ambient-robots/xlerobot_pinc/hardware/custom_parts/SO107_Elbow_Roll_Link.step

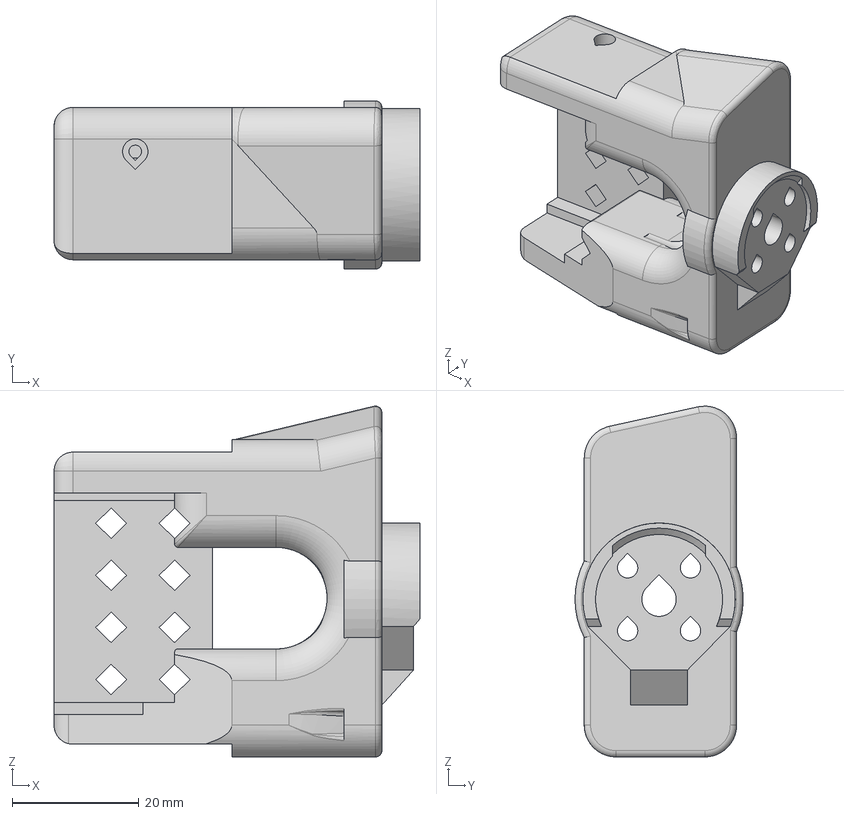
[picture p1: CAD file, 2026-03-20]
hardware/custom_parts/SO107_Elbow_Roll_Link.step
57.6 x 26.5 x 55.3 mm
