ambient-robots/xlerobot_pinc/xlerobot_pinc_urdf/assets/035armbase_step__4.stl

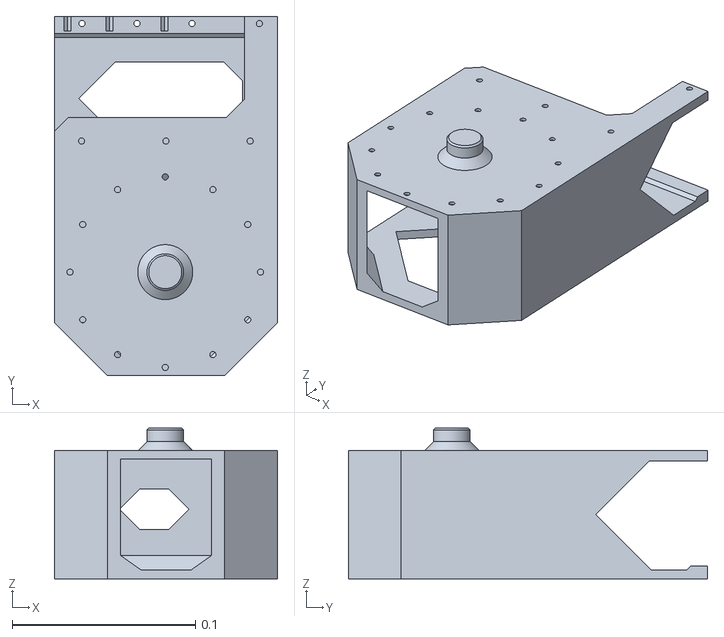
[picture p2: CAD file, 2026-03-18]
xlerobot_pinc_urdf/assets/035armbase_step__4.stl
0.122 x 0.196 x 0.0824
