ambient-robots/xlerobot_pinc/hardware/custom_parts/SO107_Elbow_Flex_Link.step

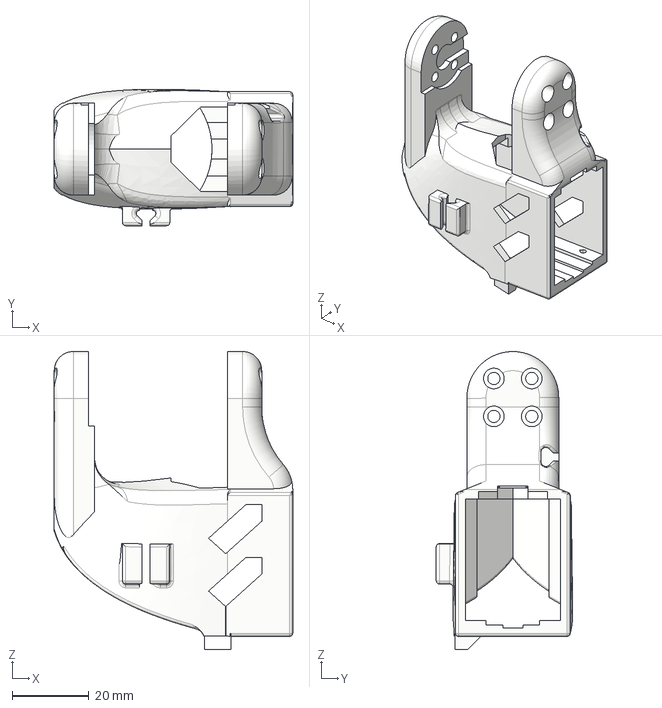
[picture p3: CAD file, 2026-03-20]
hardware/custom_parts/SO107_Elbow_Flex_Link.step
62.3 x 35.6 x 77.8 mm
