ambient-robots/xlerobot_pinc/xlerobot_pinc_urdf/assets/gimbal_base_step.stl

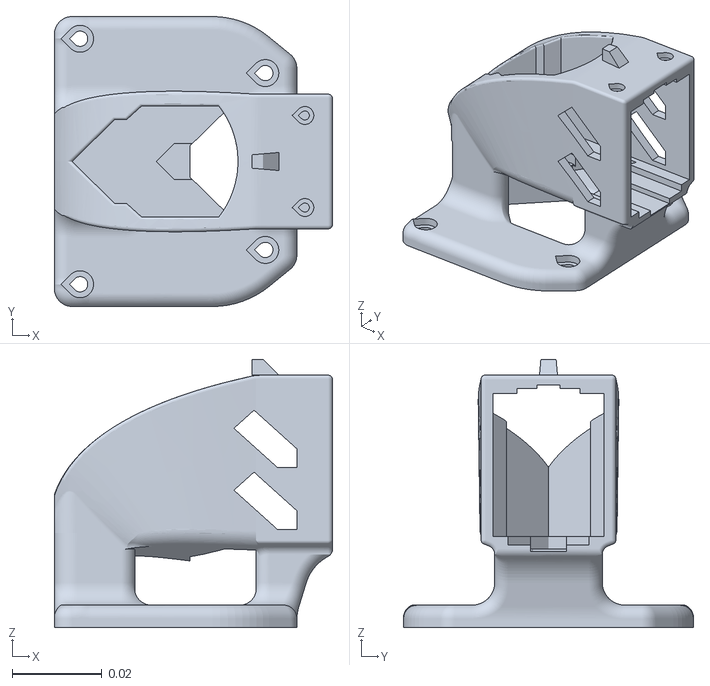
[picture p4: CAD file, 2026-03-18]
xlerobot_pinc_urdf/assets/gimbal_base_step.stl
0.062 x 0.0646 x 0.0597
