ambient-robots/xlerobot_pinc/hardware/custom_parts/PincOpen_Pointy_Tip_TPU95.step

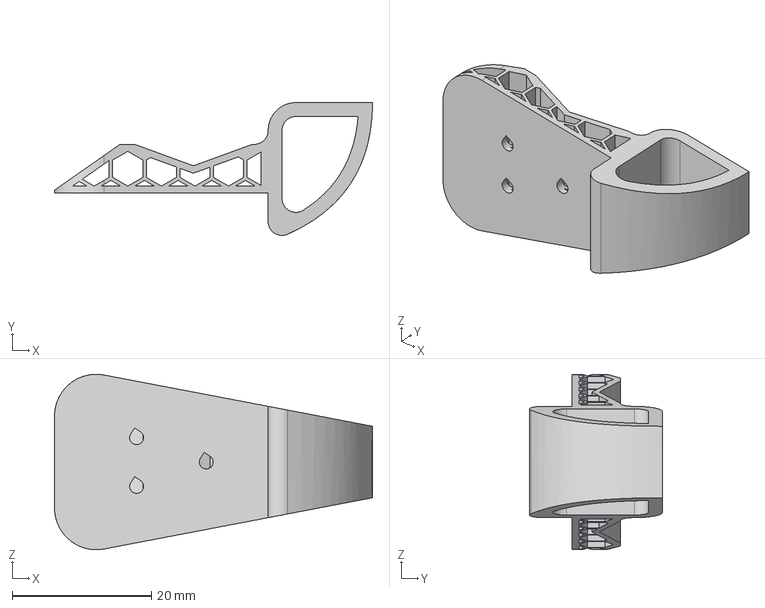
[picture p5: CAD file, 2026-03-20]
hardware/custom_parts/PincOpen_Pointy_Tip_TPU95.step
45.7 x 19.1 x 25.2 mm
