ambient-robots/xlerobot_pinc/xlerobot_pinc_urdf/assets/035armbase_step.stl

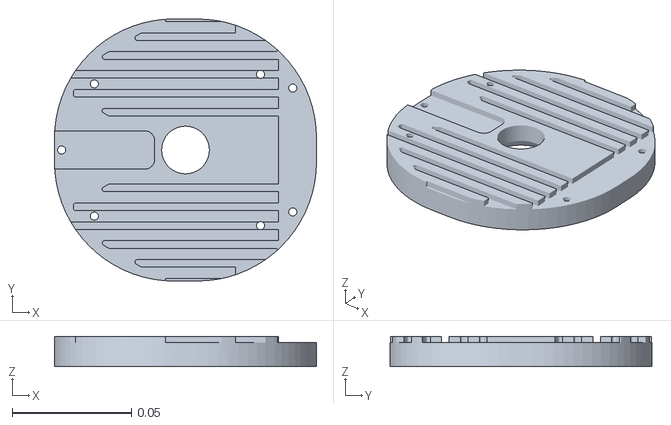
[picture p6: CAD file, 2026-03-18]
xlerobot_pinc_urdf/assets/035armbase_step.stl
0.11 x 0.11 x 0.0126
