ambient-robots/xlerobot_pinc/hardware/custom_parts/PincOpen_Fisheye_Camera_Holder_38x38.step

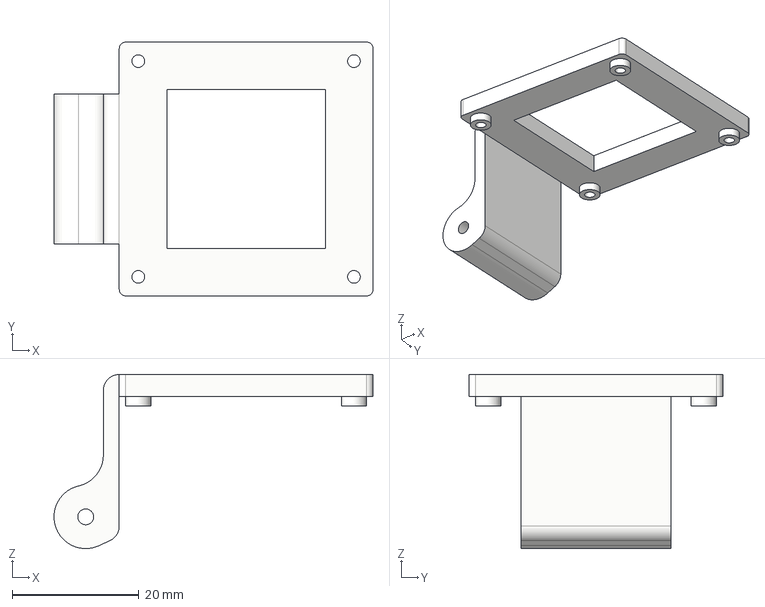
[picture p7: CAD file, 2026-03-20]
hardware/custom_parts/PincOpen_Fisheye_Camera_Holder_38x38.step
50.3 x 40.0 x 27.4 mm
