ambient-robots/xlerobot_pinc/xlerobot_pinc_urdf/assets/xlerobot_0_2_9bas_step.stl

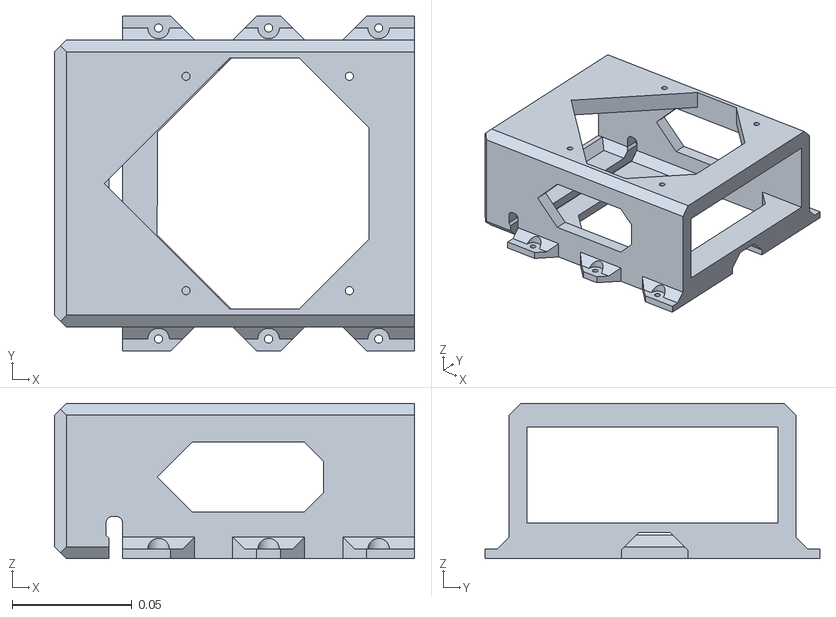
[picture p8: CAD file, 2026-03-18]
xlerobot_pinc_urdf/assets/xlerobot_0_2_9bas_step.stl
0.151 x 0.14 x 0.065
