ambient-robots/xlerobot_pinc/xlerobot_pinc_urdf/assets/xlerobot_0_2_9_3d_step.stl

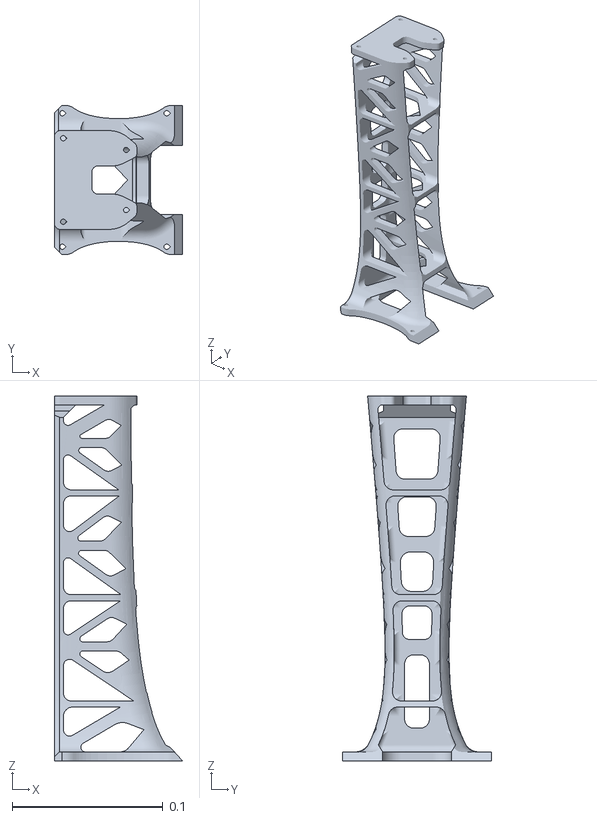
[picture p9: CAD file, 2026-03-18]
xlerobot_pinc_urdf/assets/xlerobot_0_2_9_3d_step.stl
0.0852 x 0.0992 x 0.243
