ambient-robots/xlerobot_pinc/xlerobot_pinc_urdf/assets/base_motor_holder_so101_v1.stl

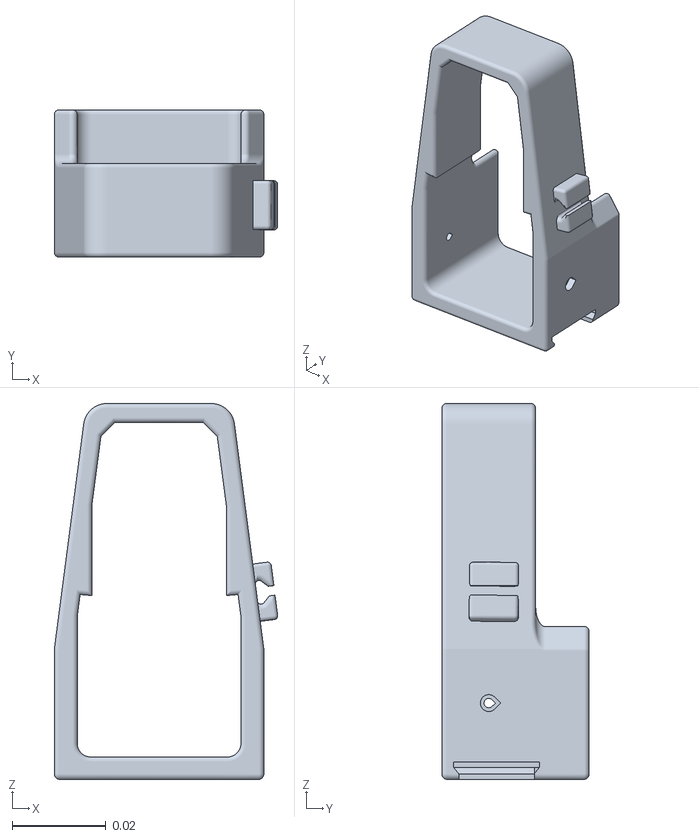
[picture p11: CAD file, 2026-03-17]
xlerobot_pinc_urdf/assets/base_motor_holder_so101_v1.stl
0.0476 x 0.0314 x 0.0802
