ambient-robots/xlerobot_pinc/xlerobot_pinc_urdf/assets/upper_arm_so101_v1.stl

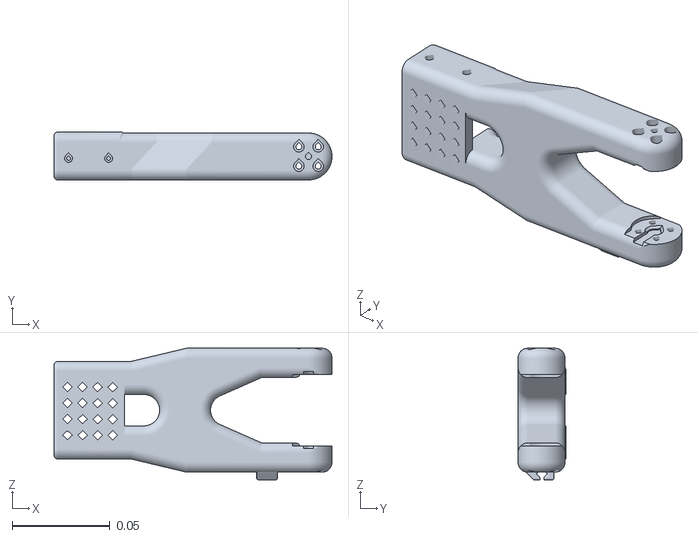
[picture p12: CAD file, 2026-03-17]
xlerobot_pinc_urdf/assets/upper_arm_so101_v1.stl
0.142 x 0.0245 x 0.0673
