ambient-robots/xlerobot_pinc/xlerobot_pinc_urdf/assets/internal_rod.stl

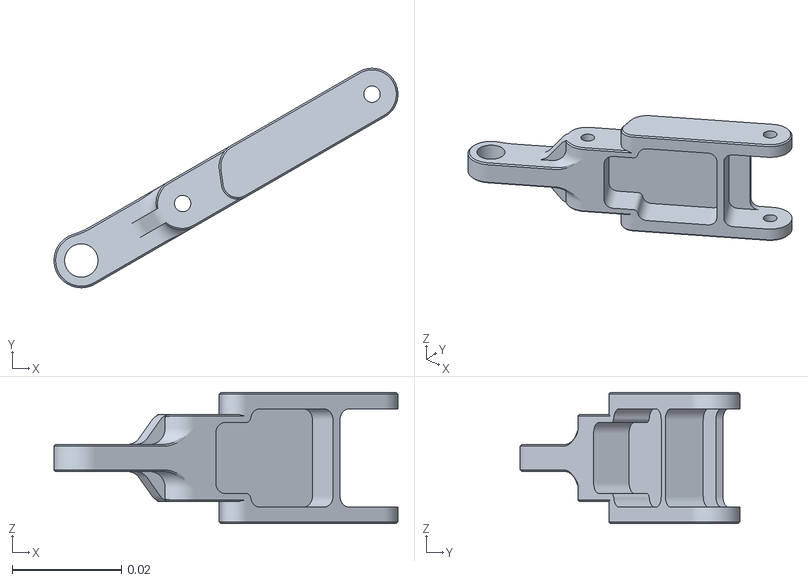
[picture p13: CAD file, 2026-03-17]
xlerobot_pinc_urdf/assets/internal_rod.stl
0.0629 x 0.0402 x 0.024
