ambient-robots/xlerobot_pinc/xlerobot_pinc_urdf/assets/sts3215_03a_v1__2.stl

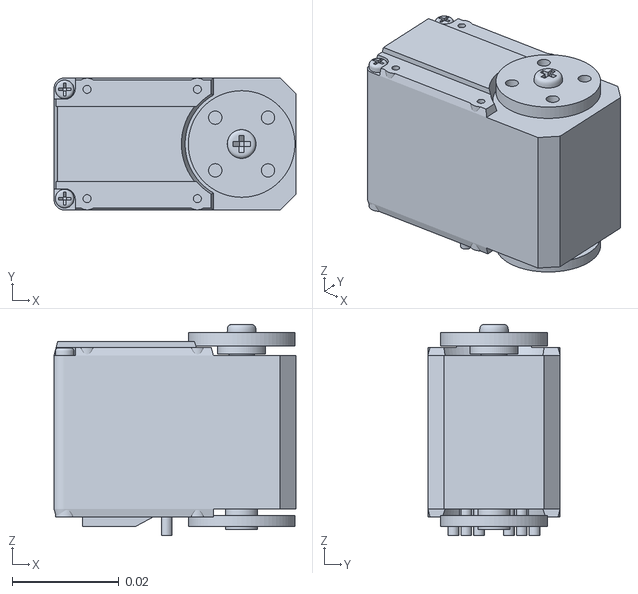
[picture p14: CAD file, 2026-03-17]
xlerobot_pinc_urdf/assets/sts3215_03a_v1__2.stl
0.0454 x 0.0248 x 0.0396
