ambient-robots/xlerobot_pinc/xlerobot_pinc_urdf/assets/top_plate.stl

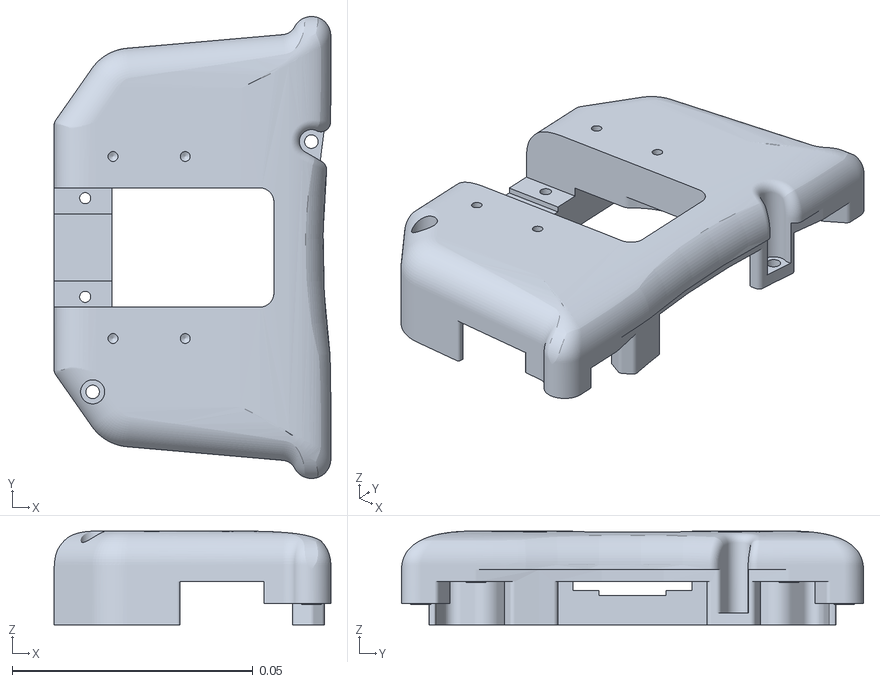
[picture p15: CAD file, 2026-03-17]
xlerobot_pinc_urdf/assets/top_plate.stl
0.0575 x 0.096 x 0.0195
