ambient-robots/xlerobot_pinc/xlerobot_pinc_urdf/assets/wrist_roll_pitch_so101_v2.stl

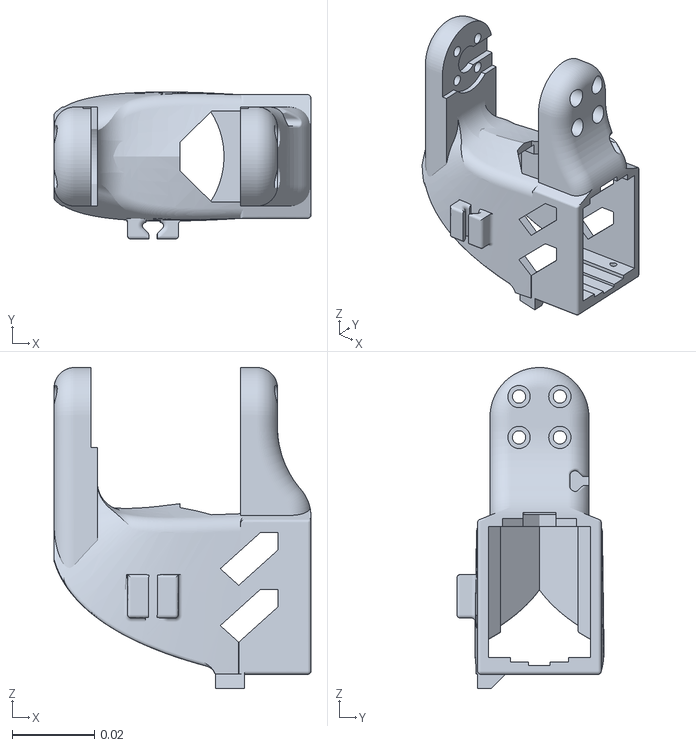
[picture p16: CAD file, 2026-03-17]
xlerobot_pinc_urdf/assets/wrist_roll_pitch_so101_v2.stl
0.0623 x 0.0357 x 0.0778
