ambient-robots/xlerobot_pinc/xlerobot_pinc_urdf/assets/rotation_pitch_so101_v1.stl

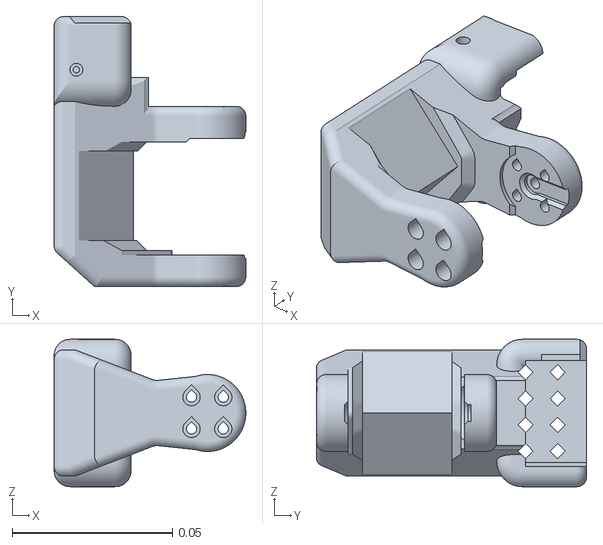
[picture p17: CAD file, 2026-03-17]
xlerobot_pinc_urdf/assets/rotation_pitch_so101_v1.stl
0.0598 x 0.0842 x 0.046
