ambient-robots/xlerobot_pinc/xlerobot_pinc_urdf/assets/removable_tip.stl

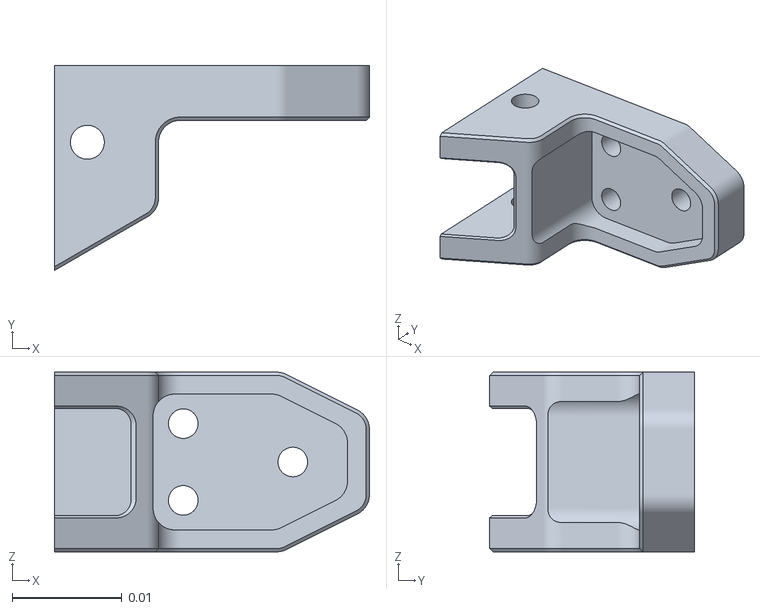
[picture p18: CAD file, 2026-03-17]
xlerobot_pinc_urdf/assets/removable_tip.stl
0.0287 x 0.0187 x 0.0164
