ambient-robots/xlerobot_pinc/xlerobot_pinc_urdf/assets/driving_rod.stl

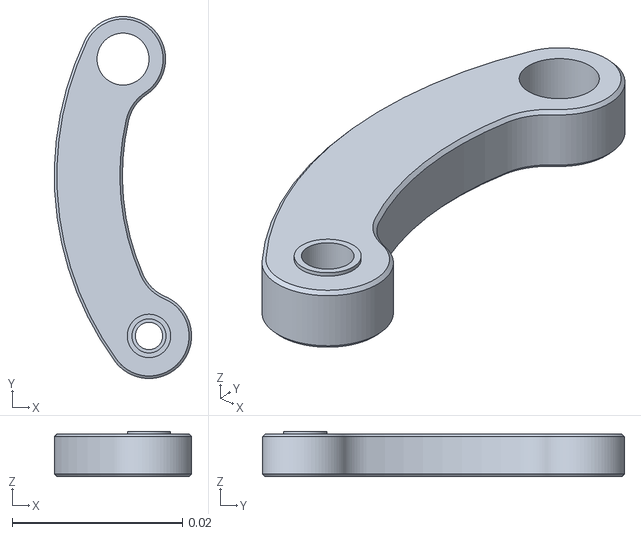
[picture p19: CAD file, 2026-03-17]
xlerobot_pinc_urdf/assets/driving_rod.stl
0.0161 x 0.0425 x 0.0053
