ambient-robots/xlerobot_pinc/xlerobot_pinc_urdf/assets/distal_rod.stl

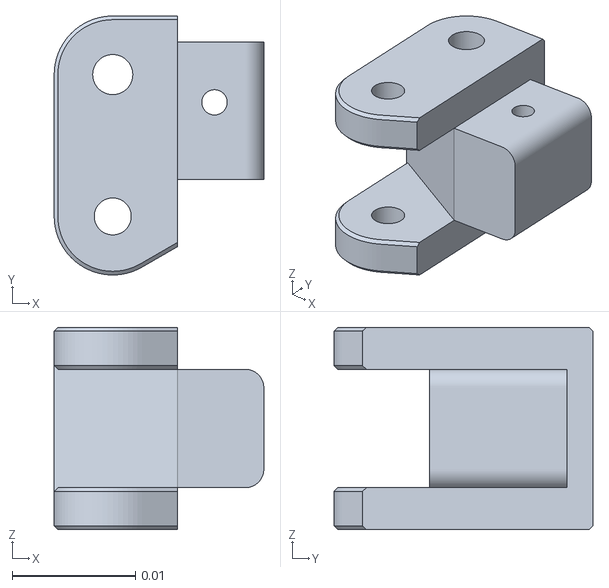
[picture p20: CAD file, 2026-03-17]
xlerobot_pinc_urdf/assets/distal_rod.stl
0.017 x 0.021 x 0.0164
