ambient-robots/xlerobot_pinc/xlerobot_pinc_urdf/assets/component1___use.stl

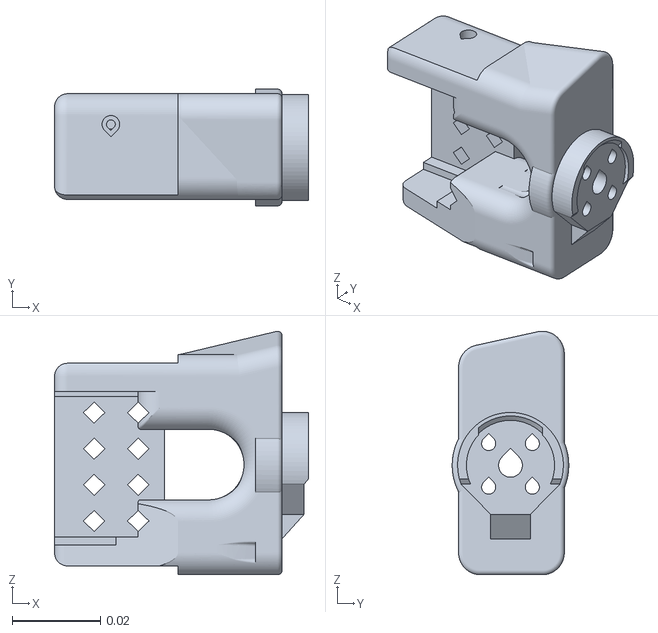
[picture p21: CAD file, 2026-03-17]
xlerobot_pinc_urdf/assets/component1___use.stl
0.0576 x 0.0265 x 0.0553
