ambient-robots/xlerobot_pinc/xlerobot_pinc_urdf/assets/distal_shell.stl

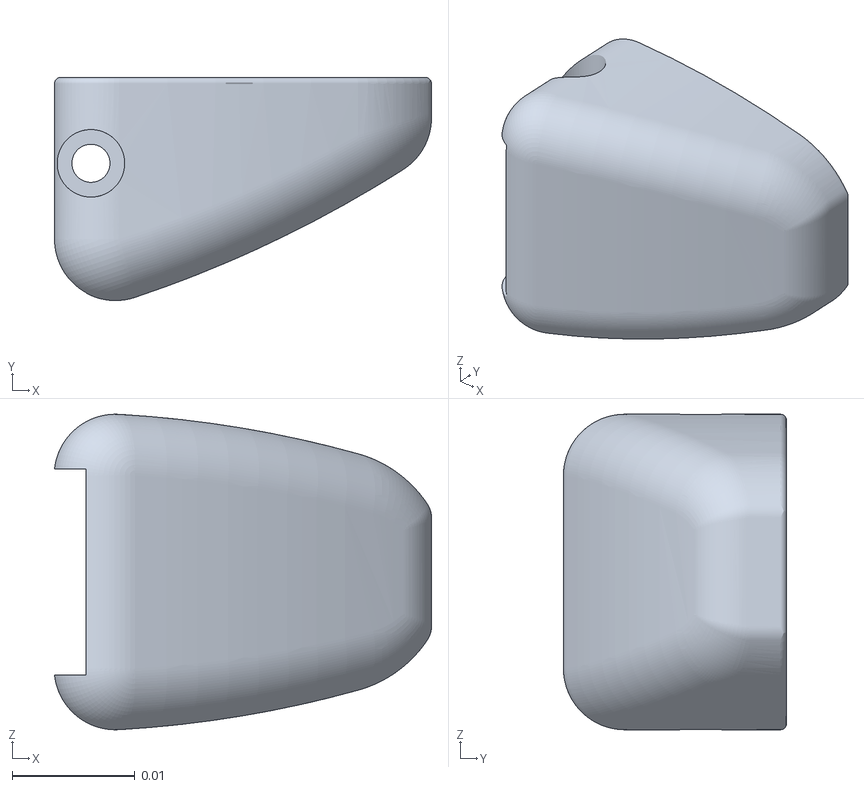
[picture p22: CAD file, 2026-03-17]
xlerobot_pinc_urdf/assets/distal_shell.stl
0.0307 x 0.0182 x 0.0257
