ambient-robots/xlerobot_pinc/xlerobot_pinc_urdf/assets/camera_mobile_sup.stl

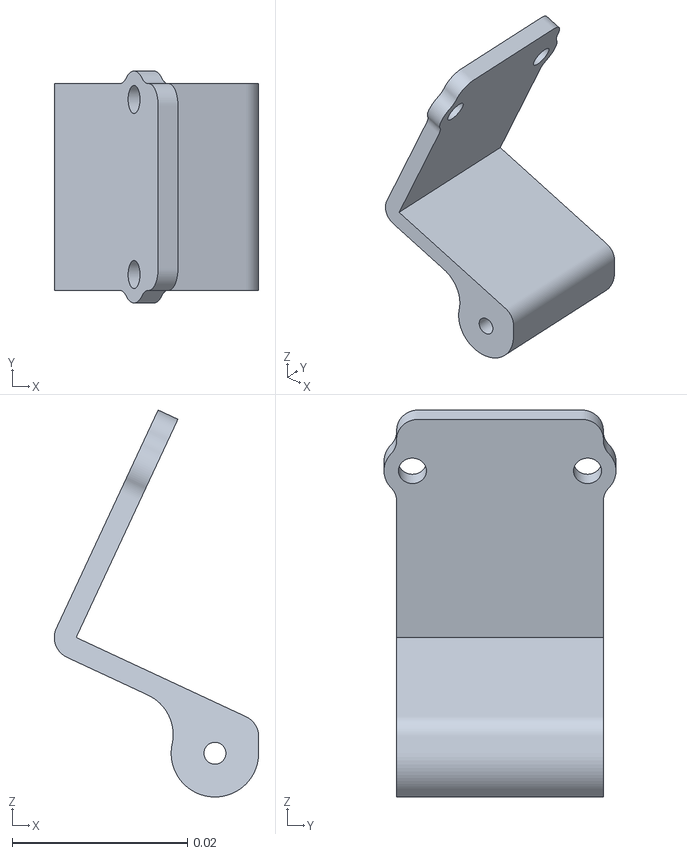
[picture p23: CAD file, 2026-03-17]
xlerobot_pinc_urdf/assets/camera_mobile_sup.stl
0.0233 x 0.0265 x 0.0442
