ambient-robots/xlerobot_pinc/xlerobot_pinc_urdf/assets/motor_holder_so101_wrist_v1.stl

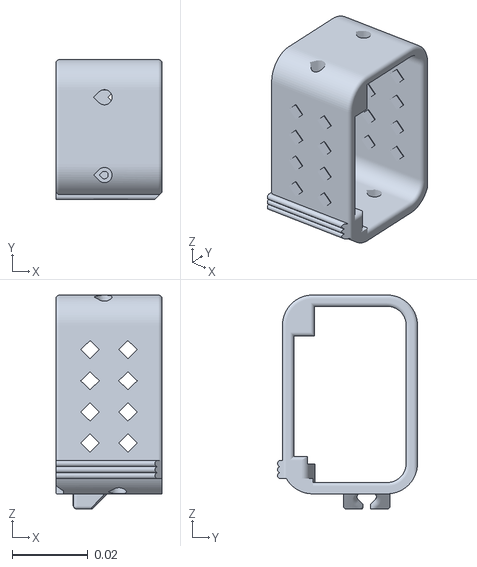
[picture p24: CAD file, 2026-03-17]
xlerobot_pinc_urdf/assets/motor_holder_so101_wrist_v1.stl
0.028 x 0.0369 x 0.0564
