ambient-robots/xlerobot_pinc/xlerobot_pinc_urdf/assets/interface_arm100.stl

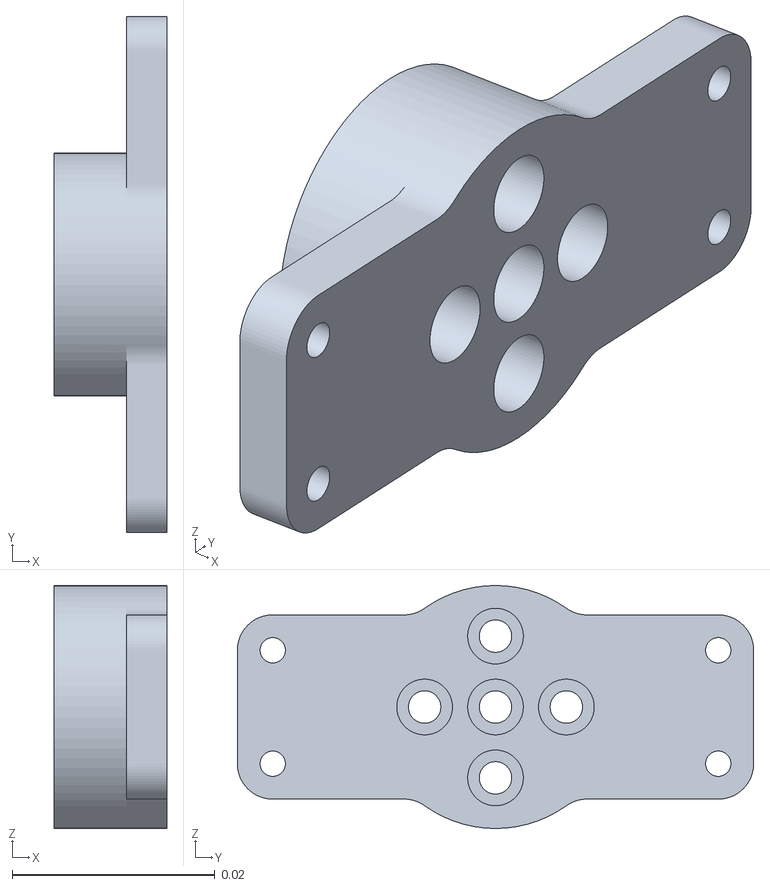
[picture p25: CAD file, 2026-03-17]
xlerobot_pinc_urdf/assets/interface_arm100.stl
0.0111 x 0.051 x 0.024
