ambient-robots/xlerobot_pinc/xlerobot_pinc_urdf/assets/pointy_tip_support.stl

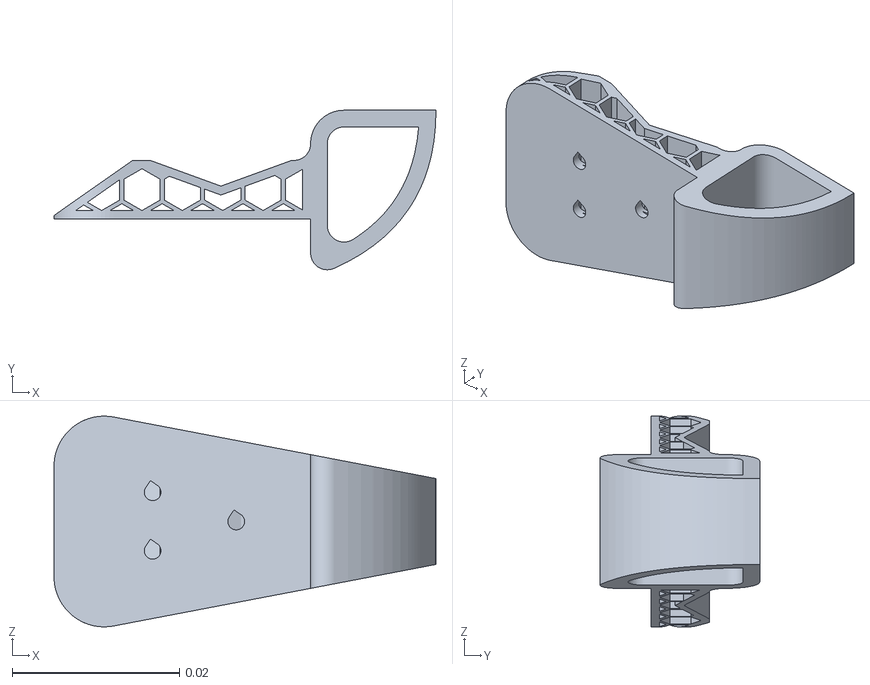
[picture p26: CAD file, 2026-03-17]
xlerobot_pinc_urdf/assets/pointy_tip_support.stl
0.0457 x 0.0191 x 0.0252
