ambient-robots/xlerobot_pinc/xlerobot_pinc_urdf/assets/motor_holder_so101_base_v1.stl

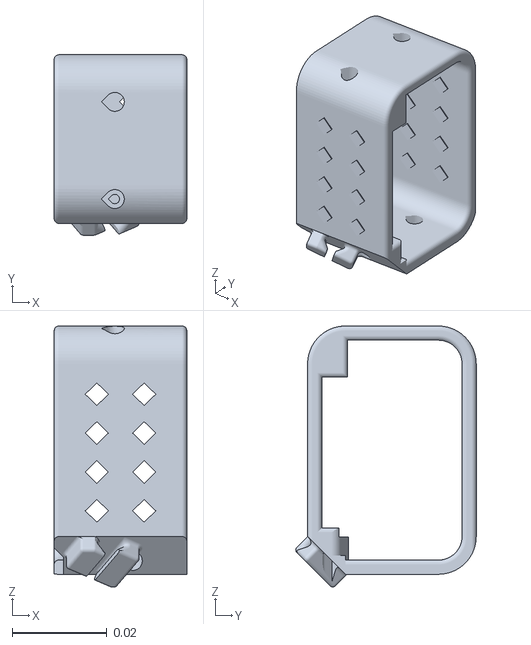
[picture p27: CAD file, 2026-03-17]
xlerobot_pinc_urdf/assets/motor_holder_so101_base_v1.stl
0.028 x 0.0381 x 0.0551
