ambient-robots/xlerobot_pinc/xlerobot_pinc_urdf/assets/cam.stl

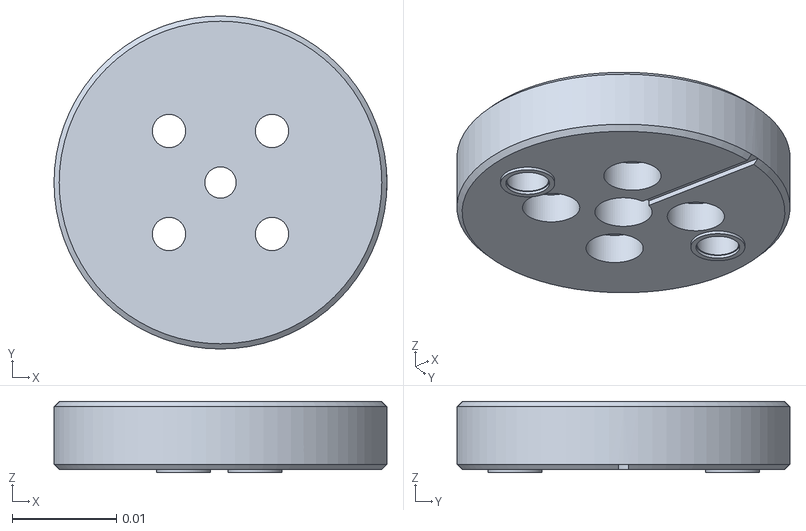
[picture p28: CAD file, 2026-03-17]
xlerobot_pinc_urdf/assets/cam.stl
0.032 x 0.032 x 0.00685
