ambient-robots/xlerobot_pinc/xlerobot_pinc_urdf/assets/external_rod.stl

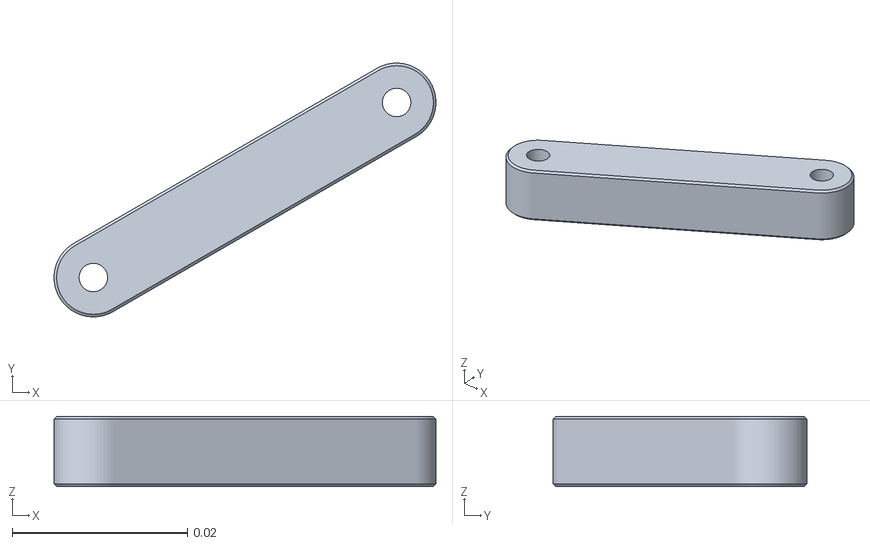
[picture p29: CAD file, 2026-03-17]
xlerobot_pinc_urdf/assets/external_rod.stl
0.0436 x 0.029 x 0.008
