ambient-robots/xlerobot_pinc/xlerobot_pinc_urdf/assets/base_so101_v2.stl

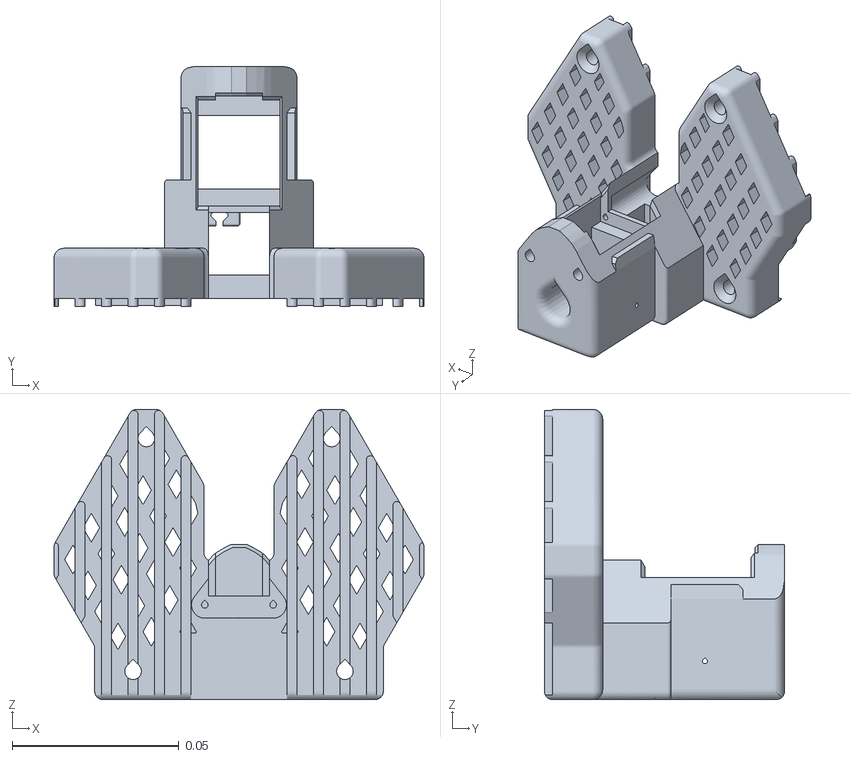
[picture p30: CAD file, 2026-03-17]
xlerobot_pinc_urdf/assets/base_so101_v2.stl
0.111 x 0.072 x 0.087
