ambient-robots/xlerobot_pinc/xlerobot_pinc_urdf/assets/camera_basement.stl

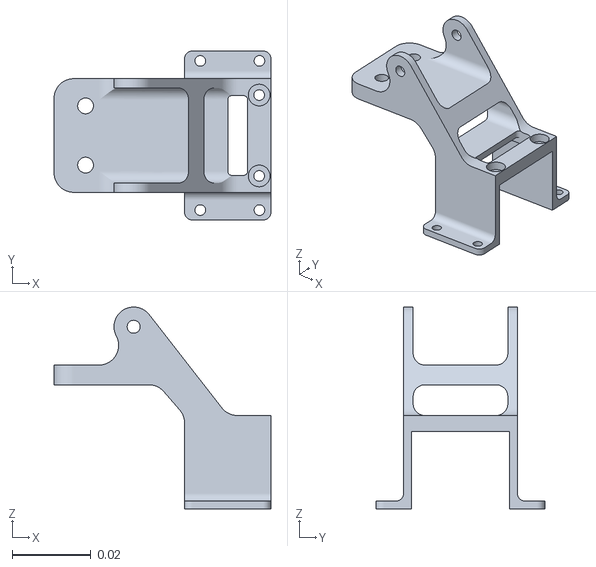
[picture p31: CAD file, 2026-03-17]
xlerobot_pinc_urdf/assets/camera_basement.stl
0.055 x 0.0428 x 0.0512
