ambient-robots/xlerobot_pinc/(list of files, cad)

Other CAD files:
xlerobot_pinc_urdf/assets/035armbase_step__3.stl
xlerobot_pinc_urdf/assets/035armbase_step__2.stl
hardware/custom_parts/PincOpen_Fisheye_Camera_Holder_38x38.stl
hardware/custom_parts/PincOpen_Pointy_Tip_TPU95.stl
hardware/custom_parts/SO107_Elbow_Flex_Link.stl
hardware/custom_parts/SO107_Elbow_Roll_Link.stl
hardware/custom_parts/SO107_Wrist_Roll_Link.stl
