ambient-robots/xlerobot_pinc/src/lerobot/robots/so107_follower/so107_follower.py

#!/usr/bin/env python

# Copyright 2025 The HuggingFace Inc. team. All rights reserved.
#
# Licensed under the Apache License, Version 2.0 (the "License");
# you may not use this file except in compliance with the License.
# You may obtain a copy of the License at
#
#     http://www.apache.org/licenses/LICENSE-2.0
#
# Unless required by applicable law or agreed to in writing, software
# distributed under the License is distributed on an "AS IS" BASIS,
# WITHOUT WARRANTIES OR CONDITIONS OF ANY KIND, either express or implied.
# See the License for the specific language governing permissions and
# limitations under the License.

import logging
import time
from functools import cached_property
from typing import Any

from lerobot.cameras.utils import make_cameras_from_configs
from lerobot.motors import Motor, MotorCalibration, MotorNormMode
from lerobot.motors.feetech import (
    FeetechMotorsBus,
    OperatingMode,
)
from lerobot.utils.errors import DeviceAlreadyConnectedError, DeviceNotConnectedError

from ..robot import Robot
from ..utils import ensure_safe_goal_position
from .config_so107_follower import SO107FollowerConfig

logger = logging.getLogger(__name__)


class SO107Follower(Robot):
    """
    SO-107 Follower Arm designed by TheRobotStudio and Hugging Face.
    """

    config_class = SO107FollowerConfig
    name = "so107_follower"

    def __init__(self, config: SO107FollowerConfig):
        super().__init__(config)
        self.config = config
        norm_mode_body = MotorNormMode.DEGREES if config.use_degrees else MotorNormMode.RANGE_M100_100
        self.bus = FeetechMotorsBus(
            port=self.config.port,
            motors={
                "shoulder_pan": Motor(1, "sts3250", norm_mode_body),
                "shoulder_lift": Motor(2, "sts3250", norm_mode_body),
                "elbow_flex": Motor(3, "sts3250", norm_mode_body),
                "elbow_roll": Motor(4, "sts3215", norm_mode_body),
                "wrist_flex": Motor(5, "sts3215", norm_mode_body),
                "wrist_roll": Motor(6, "sts3215", norm_mode_body),
                "gripper": Motor(7, "sts3215", MotorNormMode.RANGE_0_100),
            },
            calibration=self.calibration,
        )
        self.cameras = make_cameras_from_configs(config.cameras)

    @property
    def _motors_ft(self) -> dict[str, type]:
        return {f"{motor}.pos": float for motor in self.bus.motors}

    @property
    def _cameras_ft(self) -> dict[str, tuple]:
        return {
            cam: (self.config.cameras[cam].height, self.config.cameras[cam].width, 3) for cam in self.cameras
        }

    @cached_property
    def observation_features(self) -> dict[str, type | tuple]:
        return {**self._motors_ft, **self._cameras_ft}

    @cached_property
    def action_features(self) -> dict[str, type]:
        return self._motors_ft

    @property
    def is_connected(self) -> bool:
        return self.bus.is_connected and all(cam.is_connected for cam in self.cameras.values())

    def connect(self, calibrate: bool = True) -> None:
        """
        We assume that at connection time, arm is in a rest position,
        and torque can be safely disabled to run calibration.
        """
        if self.is_connected:
            raise DeviceAlreadyConnectedError(f"{self} already connected")

        self.bus.connect()
        if not self.is_calibrated and calibrate:
            logger.info(
                "Mismatch between calibration values in the motor and the calibration file or no calibration file found"
            )
            self.calibrate()

        for cam in self.cameras.values():
            cam.connect()

        self.configure()
        logger.info(f"{self} connected.")

    @property
    def is_calibrated(self) -> bool:
        return self.bus.is_calibrated

    def calibrate(self) -> None:
        fixed_range_motor = "gripper"
        if self.calibration:
            # self.calibration is not empty here
            user_input = input(
                f"Press ENTER to use provided calibration file associated with the id {self.id}, or type 'c' and press ENTER to run calibration: "
            )
            if user_input.strip().lower() != "c":
                logger.info(f"Writing calibration file associated with the id {self.id} to the motors")
                calib_to_write = {k: v for k, v in self.calibration.items() if k != fixed_range_motor}
                self.bus.write_calibration(self.calibration, cache=False)
                self.bus.calibration = self.calibration
                return

        logger.info(f"\nRunning calibration of {self}")
        self.bus.disable_torque()
        for motor in self.bus.motors:
            self.bus.write("Operating_Mode", motor, OperatingMode.POSITION.value)

        unknown_range_motors = [motor for motor in self.bus.motors if motor != fixed_range_motor]
        input(f"Move {self} (except '{fixed_range_motor}') to the middle of its range of motion and press ENTER....")
        homing_offsets = self.bus.set_half_turn_homings(unknown_range_motors)
        
        # Read homing offset of the gripper
        homing_offsets[fixed_range_motor] = self.bus.read("Homing_Offset", fixed_range_motor, normalize=False)
        logger.debug(f"Half-turn homing offsets: {homing_offsets}")

        print(
            f"Move all joints except '{fixed_range_motor}' sequentially through their entire ranges "
            "of motion.\nRecording positions. Press ENTER to stop..."
        )
        range_mins, range_maxes = self.bus.record_ranges_of_motion(unknown_range_motors)
        range_mins[fixed_range_motor] = 548 # 2048 -1500
        range_maxes[fixed_range_motor] = 2048

        self.calibration = {}
        for motor, m in self.bus.motors.items():
            self.calibration[motor] = MotorCalibration(
                id=m.id,
                drive_mode=0,
                homing_offset=homing_offsets[motor],
                range_min=range_mins[motor],
                range_max=range_maxes[motor],
            )

        # Write calibration data to motors except for the gripper
        calib_to_write = {k: v for k, v in self.calibration.items() if k != fixed_range_motor}
        self.bus.write_calibration(calib_to_write, cache=False)
        self.bus.calibration = self.calibration
        self._save_calibration()
        print("Calibration saved to", self.calibration_fpath)

    def configure(self) -> None:
        with self.bus.torque_disabled():
            self.bus.configure_motors()
            for motor in self.bus.motors:
                self.bus.write("Operating_Mode", motor, OperatingMode.POSITION.value)
                # Set P_Coefficient to lower value to avoid shakiness (Default is 32)
                self.bus.write("P_Coefficient", motor, 16)
                # Set I_Coefficient and D_Coefficient to default value 0 and 32
                self.bus.write("I_Coefficient", motor, 0)
                self.bus.write("D_Coefficient", motor, 32)

                if motor == "gripper":
                    self.bus.write("Max_Torque_Limit", motor, 800)  # 80% of the max torque limit to avoid burnout
                    self.bus.write("Torque_Limit", motor, 800)  # 80% of the max torque limit to avoid burnout
                    self.bus.write("Protection_Current", motor, 250)  # 50% of max current to avoid burnout
                    self.bus.write("Overload_Torque", motor, 80)  # 80% torque when overloaded
                    self.bus.write("Protection_Time", motor, 2) # 20ms overload protection time
                    self.bus.write("Protective_Torque", motor, 20) # 20% torque when overload is detected
                    self.bus.write("Acceleration", motor, 25) # 25*100 steps/s^2 = 220 deg/s^2 goal accelertion

    def setup_motors(self) -> None:
        for motor in reversed(self.bus.motors):
            input(f"Connect the controller board to the '{motor}' motor only and press enter.")
            self.bus.setup_motor(motor)
            print(f"'{motor}' motor id set to {self.bus.motors[motor].id}")

    def get_observation(self) -> dict[str, Any]:
        if not self.is_connected:
            raise DeviceNotConnectedError(f"{self} is not connected.")

        # Read arm position
        start = time.perf_counter()
        obs_dict = self.bus.sync_read("Present_Position")
        obs_dict = {f"{motor}.pos": val for motor, val in obs_dict.items()}
        dt_ms = (time.perf_counter() - start) * 1e3
        logger.debug(f"{self} read state: {dt_ms:.1f}ms")

        # Capture images from cameras
        camera_obs = self.get_camera_observation()
        obs_dict.update(camera_obs)

        return obs_dict
    
    def get_camera_observation(self):
        obs_dict = {}
        for cam_key, cam in self.cameras.items():
            start = time.perf_counter()
            obs_dict[cam_key] = cam.read_latest()
            dt_ms = (time.perf_counter() - start) * 1e3
            logger.debug(f"{self} read {cam_key}: {dt_ms:.1f}ms")
        
        return obs_dict

    def send_action(self, action: dict[str, Any]) -> dict[str, Any]:
        """Command arm to move to a target joint configuration.

        The relative action magnitude may be clipped depending on the configuration parameter
        `max_relative_target`. In this case, the action sent differs from original action.
        Thus, this function always returns the action actually sent.

        Raises:
            RobotDeviceNotConnectedError: if robot is not connected.

        Returns:
            the action sent to the motors, potentially clipped.
        """
        if not self.is_connected:
            raise DeviceNotConnectedError(f"{self} is not connected.")

        goal_pos = {key.removesuffix(".pos"): val for key, val in action.items() if key.endswith(".pos")}

        # Cap goal position when too far away from present position.
        # /!\ Slower fps expected due to reading from the follower.
        if self.config.max_relative_target is not None:
            present_pos = self.bus.sync_read("Present_Position")
            goal_present_pos = {key: (g_pos, present_pos[key]) for key, g_pos in goal_pos.items()}
            goal_pos = ensure_safe_goal_position(goal_present_pos, self.config.max_relative_target)

        # Send goal position to the arm
        self.bus.sync_write("Goal_Position", goal_pos)
        return {f"{motor}.pos": val for motor, val in goal_pos.items()}

    def disconnect(self):
        if not self.is_connected:
            raise DeviceNotConnectedError(f"{self} is not connected.")

        self.bus.disconnect(self.config.disable_torque_on_disconnect)
        for cam in self.cameras.values():
            cam.disconnect()

        logger.info(f"{self} disconnected.")
