ambient-robots/xlerobot_pinc/(commit log)

2025-11-13 add dual-arm-head ipol
2025-11-13 cameras working
2025-11-20 feat: modified async_read to not strictly require and wait for new frame
2025-11-20 feat: add rear camera; use unified size 640x480 and disabled depth camera
    pi 0.6 uses camera input of sizes 448x448 and ignores depth channel
    rear camera together with head camera should provide capability of
    environment modeling
2025-11-26 feat: add modified kinematics via plato
2025-12-09 use RGB mode for all cameras
2025-12-27 fix: do not write calibration data to gripper motor
    [so107_follower.py]
2025-12-30 fix: do not use cached calibration after writing otherwise gripper calibration is gone
    [so107_follower.py]
2025-12-30 add kinematic processer (same as so100)
2026-01-02 fix: minor fix calibration
    [config_xlerobot_pro.py, xlerobot_pro.py]
2026-01-03 chore: comment out user-specific camera configs
2026-01-03 feat: add robot config and class for xlerobot_pro tah (two-arm-head)
2026-01-03 chore: add argumet to decide wether printing control goals
2026-01-03 feat: use analog values of trigger for robotic gripper control
2026-01-05 fix: update saved calibration for gripper from device
    In case gripper motor's calibration is modified on device, saved
    caibration file needs to be updated.
    [xlerobot_pro.py]
2026-01-05 chore (examples): disable keyboard teleop of right arm in wz direction
    lerobot's keyboard teleop does set released for keys '+' and '#',
    leading to unstoppable motions.
2026-01-11 feat: add motor_id_tool script to scan for motors and set ids individually
2026-01-19 feat: add script with relative motion filter
2026-01-25 fix (xlevr): buttons can be None
2026-01-31 feat: enable joint limits and regulation task in ik
2026-02-01 fix: restore calibration explicitly after bus write
    [so107_follower.py]
2026-02-01 chore: add camera warmup time
2026-02-10 feat: use YUYV for uvc cameras to avoid data corruption
    [config_xlerobot_pro.py]
2026-02-25 feat(xlerobot): load camera settings from structured user config
2026-02-25 docs(readme): streamline quick-start onboarding flow
2026-03-17 add bom
2026-03-17 Fix formatting of Bill of Materials in README
    Updated the Bill of Materials section formatting.
2026-03-17 Fix BOM section formatting in README.md
2026-03-17 Enhance cables and connectors table with comments
    Added comments to cables and connectors table for clarity.
2026-03-17 feat: refactor repo for open sourcing
    [base_motor_holder_so101_v1.stl, base_so101_v2.stl, bottom_plate.stl, cam.stl, camera_basement.stl, camera_mobile_sup.stl, component1___use.stl, distal_rod.stl]
2026-03-18 chore: rename urdf
    [base_motor_holder_so101_v1.stl, base_so101_v2.stl, bottom_plate.stl, cam.stl, camera_basement.stl, camera_mobile_sup.stl, component1___use.stl, distal_rod.stl]
2026-03-18 feat: replace urdf
    [035armbase_step.stl, 035armbase_step__2.stl, 035armbase_step__3.stl, 035armbase_step__4.stl, gimbal_base_step.stl, gripper.urdf, robot.urdf, xlerobot.urdf]
2026-03-18 fix: add gripper_frame_link
    [robot.urdf]
2026-03-18 Resolve bundled URDF path in env loader
    [9_vr_teleop_xlerobot_pinc_dualarm_w_dataset_recording.py]
2026-03-18 fix: increase max_age_ms reduced by lerobot
    [xlerobot_pinc.py]
2026-03-20 docs: add custom hardware parts and refine hardware docs
    [PincOpen_Fisheye_Camera_Holder_38x38.step, PincOpen_Fisheye_Camera_Holder_38x38.stl, PincOpen_Pointy_Tip_TPU95.step, PincOpen_Pointy_Tip_TPU95.stl, SO107_Wrist_Roll_Link.step, SO107_Wrist_Roll_Link.stl]
2026-03-20 docs: rewrite xlevr readme for placo teleop flow
2026-03-20 feat: replace wrist roll part with split elbow links
    [SO107_Elbow_Flex_Link.step, SO107_Elbow_Flex_Link.stl, SO107_Elbow_Roll_Link.step, SO107_Elbow_Roll_Link.stl]
2026-03-20 fix: keep torque disabled during arm calibration
    [xlerobot_pinc.py]
2026-03-21 fix(joint_controller): mesh paths
2026-03-21 fix(gripper.urdf): make gripper base link name match the arm tcp name, i.e. rename gripper to cam
    [gripper.urdf]
2026-03-22 fix(README): fix wrong link to joint controller
2026-04-03 feat: update link to connectors
2026-04-03 feat(BOM): improve comment
2026-04-11 Refactor dual-arm inference and add RTC example
2026-04-11 fix: stabilize dual-arm rtc inference loop
    [pi05_inference_rtc_dualarm.py]
